Gun98/STM32-FreeRTOS-Sensor-Controller/Core/Src/main.c

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
/* Includes ------------------------------------------------------------------*/
#include "main.h"
#include "cmsis_os.h"

/* USER CODE BEGIN Includes */
#include "app.h"
#include "app_tasks.h"
#include "app_types.h"

#include "FreeRTOS.h"
#include "self_test.h"
#include "stream_buffer.h"
#include "system_health.h"
#include "task.h"
#include "uart_protocol.h"
#include "uart_tx.h"
/* USER CODE END Includes */

I2C_HandleTypeDef hi2c1;

IWDG_HandleTypeDef hiwdg;

TIM_HandleTypeDef htim2;
TIM_HandleTypeDef htim3;
TIM_HandleTypeDef htim4;

UART_HandleTypeDef huart2;
DMA_HandleTypeDef hdma_usart2_tx;

/* Definitions for appTask */
osThreadId_t appTaskHandle;
const osThreadAttr_t appTask_attributes = {
  .name = "appTask",
  .stack_size = 512 * 4,
  .priority = (osPriority_t) osPriorityNormal,
};
/* Definitions for heartbeatTask */
osThreadId_t heartbeatTaskHandle;
const osThreadAttr_t heartbeatTask_attributes = {
  .name = "heartbeatTask",
  .stack_size = 128 * 4,
  .priority = (osPriority_t) osPriorityLow,
};
/* Definitions for consumerTask */
osThreadId_t consumerTaskHandle;
const osThreadAttr_t consumerTask_attributes = {
  .name = "consumerTask",
  .stack_size = 128 * 4,
  .priority = (osPriority_t) osPriorityBelowNormal,
};
/* Definitions for eventTask */
osThreadId_t eventTaskHandle;
const osThreadAttr_t eventTask_attributes = {
  .name = "eventTask",
  .stack_size = 128 * 4,
  .priority = (osPriority_t) osPriorityBelowNormal,
};
/* Definitions for monitorTask */
osThreadId_t monitorTaskHandle;
const osThreadAttr_t monitorTask_attributes = {
  .name = "monitorTask",
  .stack_size = 128 * 4,
  .priority = (osPriority_t) osPriorityLow,
};
/* Definitions for commandTask */
osThreadId_t commandTaskHandle;
const osThreadAttr_t commandTask_attributes = {
  .name = "commandTask",
  .stack_size = 384 * 4,
  .priority = (osPriority_t) osPriorityNormal,
};
/* Definitions for watchdogTask */
osThreadId_t watchdogTaskHandle;
const osThreadAttr_t watchdogTask_attributes = {
  .name = "watchdogTask",
  .stack_size = 128 * 4,
  .priority = (osPriority_t) osPriorityNormal,
};
/* Definitions for uartTxTask */
osThreadId_t uartTxTaskHandle;
const osThreadAttr_t uartTxTask_attributes = {
  .name = "uartTxTask",
  .stack_size = 256 * 4,
  .priority = (osPriority_t) osPriorityNormal,
};
/* Definitions for counterQueue */
osMessageQueueId_t counterQueueHandle;
const osMessageQueueAttr_t counterQueue_attributes = {
  .name = "counterQueue"
};
/* Definitions for controlQueue */
osMessageQueueId_t controlQueueHandle;
const osMessageQueueAttr_t controlQueue_attributes = {
  .name = "controlQueue"
};
/* Definitions for uartTxQueue */
osMessageQueueId_t uartTxQueueHandle;
const osMessageQueueAttr_t uartTxQueue_attributes = {
  .name = "uartTxQueue"
};
/* Definitions for statusTimer */
osTimerId_t statusTimerHandle;
const osTimerAttr_t statusTimer_attributes = {
  .name = "statusTimer"
};
/* Definitions for systemEvent */
osEventFlagsId_t systemEventHandle;
const osEventFlagsAttr_t systemEvent_attributes = {
  .name = "systemEvent"
};
/* Definitions for healthEvent */
osEventFlagsId_t healthEventHandle;
const osEventFlagsAttr_t healthEvent_attributes = {
  .name = "healthEvent"
};
/* USER CODE BEGIN PV */
static StreamBufferHandle_t
    uartRxStreamBufferHandle = NULL;
/* USER CODE END PV */

void SystemClock_Config(void);
static void MX_GPIO_Init(void);
static void MX_DMA_Init(void);
static void MX_TIM3_Init(void);
static void MX_USART2_UART_Init(void);
static void MX_I2C1_Init(void);
static void MX_TIM4_Init(void);
static void MX_TIM2_Init(void);
static void MX_IWDG_Init(void);
void StartAppTask(void *argument);
void StartHeartbeatTask(void *argument);
void StartConsumerTask(void *argument);
void StartEventTask(void *argument);
void StartMonitorTask(void *argument);
void StartCommandTask(void *argument);
void StartWatchdogTask(void *argument);
void StartUartTxTask(void *argument);
void StatusTimerCallback(void *argument);

/**
  * @brief  The application entry point.
  * @retval int
  */
int main(void)
{

  /* USER CODE BEGIN 1 */
  SystemHealth_CaptureResetCause(
      RCC->CSR);
/* USER CODE END 1 */

  /* MCU Configuration--------------------------------------------------------*/

  /* Reset of all peripherals, Initializes the Flash interface and the Systick. */
  HAL_Init();

  /* USER CODE BEGIN Init */
  __HAL_RCC_CLEAR_RESET_FLAGS();

  #if defined(DEBUG)
    __HAL_DBGMCU_FREEZE_IWDG();
  #endif

  __HAL_RCC_CLEAR_RESET_FLAGS();
/* USER CODE END Init */

  /* Configure the system clock */
  SystemClock_Config();

  /* Initialize all configured peripherals */
  MX_GPIO_Init();
  MX_DMA_Init();
  MX_TIM3_Init();
  MX_USART2_UART_Init();
  MX_I2C1_Init();
  MX_TIM4_Init();
  MX_TIM2_Init();
  MX_IWDG_Init();
  /* USER CODE BEGIN 2 */
  static const AppHardware_t hardware =
  {
      .i2c = &hi2c1,
      .uart = &huart2,

      .hcsr04_timer = &htim3,
      .hcsr04_channel = TIM_CHANNEL_1,
      .hcsr04_trig_port = GPIOB,
      .hcsr04_trig_pin = GPIO_PIN_5,

      .buzzer_timer = &htim4,
      .buzzer_channel = TIM_CHANNEL_1,

      .servo_timer = &htim2,
      .servo_channel = TIM_CHANNEL_3
  };

  App_Init(&hardware);

//  App_Init(&app_hardware);
  /* USER CODE END 2 */

  /* Init scheduler */
  osKernelInitialize();

  /* USER CODE BEGIN RTOS_MUTEX */
  /* add mutexes, ... */
  /* USER CODE END RTOS_MUTEX */

  /* USER CODE BEGIN RTOS_SEMAPHORES */
  /* add semaphores, ... */
  /* USER CODE END RTOS_SEMAPHORES */

  /* Create the timer(s) */
  /* creation of statusTimer */
  statusTimerHandle = osTimerNew(StatusTimerCallback, osTimerPeriodic, NULL, &statusTimer_attributes);

  /* USER CODE BEGIN RTOS_TIMERS */
  /* start timers, add new ones, ... */
  /* USER CODE END RTOS_TIMERS */

  /* Create the queue(s) */
  /* creation of counterQueue */
  counterQueueHandle = osMessageQueueNew (4, sizeof(SensorMessage_t), &counterQueue_attributes);

  /* creation of controlQueue */
  controlQueueHandle = osMessageQueueNew (8, sizeof(uint8_t), &controlQueue_attributes);

  /* creation of uartTxQueue */
  uartTxQueueHandle = osMessageQueueNew (4, sizeof(UartTxMessage_t), &uartTxQueue_attributes);

  /* USER CODE BEGIN RTOS_QUEUES */
  /* add queues, ... */
  /*
   * UART RX Byte Stream
   *
   * 전체 저장 공간: 64Byte
   * Trigger Level: 1Byte
   */
  uartRxStreamBufferHandle =
      xStreamBufferCreate(
          64U,
          1U);
  /* USER CODE END RTOS_QUEUES */

  /* Create the thread(s) */
  /* creation of appTask */
  appTaskHandle = osThreadNew(StartAppTask, NULL, &appTask_attributes);

  /* creation of heartbeatTask */
  heartbeatTaskHandle = osThreadNew(StartHeartbeatTask, NULL, &heartbeatTask_attributes);

  /* creation of consumerTask */
  consumerTaskHandle = osThreadNew(StartConsumerTask, NULL, &consumerTask_attributes);

  /* creation of eventTask */
  eventTaskHandle = osThreadNew(StartEventTask, NULL, &eventTask_attributes);

  /* creation of monitorTask */
  monitorTaskHandle = osThreadNew(StartMonitorTask, NULL, &monitorTask_attributes);

  /* creation of commandTask */
  commandTaskHandle = osThreadNew(StartCommandTask, NULL, &commandTask_attributes);

  /* creation of watchdogTask */
  watchdogTaskHandle = osThreadNew(StartWatchdogTask, NULL, &watchdogTask_attributes);

  /* creation of uartTxTask */
  uartTxTaskHandle = osThreadNew(StartUartTxTask, NULL, &uartTxTask_attributes);

  /* USER CODE BEGIN RTOS_THREADS */
  /* add threads, ... */
  /* USER CODE END RTOS_THREADS */

  /* Create the event(s) */
  /* creation of systemEvent */
  systemEventHandle = osEventFlagsNew(&systemEvent_attributes);

  /* creation of healthEvent */
  healthEventHandle = osEventFlagsNew(&healthEvent_attributes);

  /* USER CODE BEGIN RTOS_EVENTS */
  const AppTasksContext_t app_tasks_context =
  {
      .counter_queue = counterQueueHandle,
      .control_queue = controlQueueHandle,
      .system_event = systemEventHandle,
      .status_timer = statusTimerHandle
  };

  const UartProtocolContext_t protocol_context =
  {
      .uart = &huart2,
      .rx_stream_buffer = uartRxStreamBufferHandle,
      .control_queue = controlQueueHandle
  };

  const SystemHealthContext_t health_context =
  {
      .iwdg = &hiwdg,
      .health_event = healthEventHandle,
      .app_task = appTaskHandle,
      .heartbeat_task = heartbeatTaskHandle,
      .consumer_task = consumerTaskHandle,
      .event_task = eventTaskHandle,
      .monitor_task = monitorTaskHandle,
      .command_task = commandTaskHandle,
      .watchdog_task = watchdogTaskHandle,
      .uart_tx_task = uartTxTaskHandle
  };

  const SelfTestRtosObjects_t self_test_objects =
  {
      .app_task = appTaskHandle,
      .heartbeat_task = heartbeatTaskHandle,
      .consumer_task = consumerTaskHandle,
      .event_task = eventTaskHandle,
      .monitor_task = monitorTaskHandle,
      .command_task = commandTaskHandle,
      .watchdog_task = watchdogTaskHandle,
      .uart_tx_task = uartTxTaskHandle,
      .counter_queue = counterQueueHandle,
      .control_queue = controlQueueHandle,
      .uart_tx_queue = uartTxQueueHandle,
      .uart_rx_stream_buffer = uartRxStreamBufferHandle,
      .status_timer = statusTimerHandle,
      .system_event = systemEventHandle,
      .health_event = healthEventHandle
  };

  UartTx_Init(
      &huart2,
      uartTxQueueHandle,
      uartTxTaskHandle);

  AppTasks_Init(
      &app_tasks_context);

  UartProtocol_Init(
      &protocol_context);

  SystemHealth_Init(
      &health_context);

  if (SelfTest_Init(
          &hi2c1,
          &self_test_objects) == 0U)
  {
    Error_Handler();
  }
  /* add events, ... */
/* USER CODE END RTOS_EVENTS */

  /* Start scheduler */
  osKernelStart();

  /* We should never get here as control is now taken by the scheduler */

  /* Infinite loop */
  /* USER CODE BEGIN WHILE */
  while (1)
  {

    /* USER CODE END WHILE */

    /* USER CODE BEGIN 3 */
  }
  /* USER CODE END 3 */
}

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
/* USER CODE BEGIN 4 */
void HAL_GPIO_EXTI_Callback(
    uint16_t GPIO_Pin)
{
  AppTasks_OnButtonInterrupt(
      GPIO_Pin);
}

void HAL_UART_RxCpltCallback(
    UART_HandleTypeDef *huart)
{
  UartProtocol_OnReceiveComplete(
      huart);
}

void HAL_UART_TxCpltCallback(
    UART_HandleTypeDef *huart)
{
  UartTx_OnTransmitComplete(
      huart);
}

void vApplicationStackOverflowHook(
    TaskHandle_t xTask,
    char *pcTaskName)
{
  (void)xTask;
  (void)pcTaskName;

  SystemHealth_OnStackOverflow();
}

void vApplicationMallocFailedHook(void)
{
  SystemHealth_OnMallocFailed();
}

void HardFault_C(
    uint32_t *fault_stack,
    uint32_t exc_return)
{
  SystemHealth_CaptureHardFault(
      fault_stack,
      exc_return);
}
/* USER CODE END 4 */

/* USER CODE BEGIN Header_StartAppTask */
/**
  * @brief  Function implementing the appTask thread.
  * @param  argument: Not used
  * @retval None
  */
/* USER CODE END Header_StartAppTask */
void StartAppTask(void *argument)
{
  /* USER CODE BEGIN 5 */
	/* USER CODE BEGIN StartAppTask */
  AppTask_Run(argument);
/* USER CODE END StartAppTask */
  /* USER CODE END 5 */
}

/* USER CODE BEGIN Header_StartHeartbeatTask */
/**
* @brief Function implementing the heartbeatTask thread.
* @param argument: Not used
* @retval None
*/
/* USER CODE END Header_StartHeartbeatTask */
void StartHeartbeatTask(void *argument)
{
  /* USER CODE BEGIN StartHeartbeatTask */
  HeartbeatTask_Run(argument);
/* USER CODE END StartHeartbeatTask */
}

/* USER CODE BEGIN Header_StartConsumerTask */
/**
* @brief Function implementing the consumerTask thread.
* @param argument: Not used
* @retval None
*/
/* USER CODE END Header_StartConsumerTask */
void StartConsumerTask(void *argument)
{
  /* USER CODE BEGIN StartConsumerTask */
  ConsumerTask_Run(argument);
/* USER CODE END StartConsumerTask */
}

/* USER CODE BEGIN Header_StartEventTask */
/**
* @brief Function implementing the eventTask thread.
* @param argument: Not used
* @retval None
*/
/* USER CODE END Header_StartEventTask */
void StartEventTask(void *argument)
{
  /* USER CODE BEGIN StartEventTask */
  EventTask_Run(argument);
/* USER CODE END StartEventTask */
}

/* USER CODE BEGIN Header_StartMonitorTask */
/**
* @brief Function implementing the monitorTask thread.
* @param argument: Not used
* @retval None
*/
/* USER CODE END Header_StartMonitorTask */
void StartMonitorTask(void *argument)
{
  /* USER CODE BEGIN StartMonitorTask */
  MonitorTask_Run(argument);
/* USER CODE END StartMonitorTask */
}

/* USER CODE BEGIN Header_StartCommandTask */
/**
* @brief Function implementing the commandTask thread.
* @param argument: Not used
* @retval None
*/
/* USER CODE END Header_StartCommandTask */
void StartCommandTask(void *argument)
{
  /* USER CODE BEGIN StartCommandTask */
  CommandTask_Run(argument);
/* USER CODE END StartCommandTask */
}

/* USER CODE BEGIN Header_StartWatchdogTask */
/**
* @brief Function implementing the watchdogTask thread.
* @param argument: Not used
* @retval None
*/
/* USER CODE END Header_StartWatchdogTask */
void StartWatchdogTask(void *argument)
{
  /* USER CODE BEGIN StartWatchdogTask */
  WatchdogTask_Run(argument);
/* USER CODE END StartWatchdogTask */
}

/* USER CODE BEGIN Header_StartUartTxTask */
/**
* @brief Function implementing the uartTxTask thread.
* @param argument: Not used
* @retval None
*/
/* USER CODE END Header_StartUartTxTask */
void StartUartTxTask(void *argument)
{
  /* USER CODE BEGIN StartUartTxTask */
  UartTxTask_Run(argument);
/* USER CODE END StartUartTxTask */
}

/* StatusTimerCallback function */
void StatusTimerCallback(void *argument)
{
  /* USER CODE BEGIN StatusTimerCallback */
  (void)argument;

  AppTasks_OnStatusTimer();
/* USER CODE END StatusTimerCallback */
}

/**
  * @brief  Period elapsed callback in non blocking mode
  * @note   This function is called  when TIM5 interrupt took place, inside
  * HAL_TIM_IRQHandler(). It makes a direct call to HAL_IncTick() to increment
  * a global variable "uwTick" used as application time base.
  * @param  htim : TIM handle
  * @retval None
  */
void HAL_TIM_PeriodElapsedCallback(TIM_HandleTypeDef *htim)
{
  if (htim->Instance == TIM5)
  {
    HAL_IncTick();
  }
}

/**
  * @brief  This function is executed in case of error occurrence.
  * @retval None
  */
void Error_Handler(void)
{
  /* USER CODE BEGIN Error_Handler_Debug */
  /* User can add his own implementation to report the HAL error return state */
  __disable_irq();
  while (1)
  {
  }
  /* USER CODE END Error_Handler_Debug */
}
#ifdef USE_FULL_ASSERT
/**
  * @brief  Reports the name of the source file and the source line number
  *         where the assert_param error has occurred.
  * @param  file: pointer to the source file name
  * @param  line: assert_param error line source number
  * @retval None
  */
void assert_failed(uint8_t *file, uint32_t line)
{
  /* USER CODE BEGIN 6 */
  /* User can add his own implementation to report the file name and line number,
     ex: printf("Wrong parameters value: file %s on line %d\r\n", file, line) */
  /* USER CODE END 6 */
}
#endif /* USE_FULL_ASSERT */
