Gun98/STM32-FreeRTOS-Sensor-Controller/Core/Inc/app.h

/*
 * app.h
 *
 *  Created on: 2026. 7. 20.
 *      Author: ACER
 */

#ifndef INC_APP_H_
#define INC_APP_H_

#include "main.h"
#include "app_types.h"


typedef struct
{
    I2C_HandleTypeDef *i2c;
    UART_HandleTypeDef *uart;

    TIM_HandleTypeDef *hcsr04_timer;
    uint32_t hcsr04_channel;
    GPIO_TypeDef *hcsr04_trig_port;
    uint16_t hcsr04_trig_pin;

    TIM_HandleTypeDef *buzzer_timer;
    uint32_t buzzer_channel;

    TIM_HandleTypeDef *servo_timer;
    uint32_t servo_channel;
} AppHardware_t;

void App_Init(const AppHardware_t *hardware);

void App_Run(void);

uint8_t App_GetSensorSnapshot(SensorMessage_t *message);

#endif /* INC_APP_H_ */
