Gun98/STM32-FreeRTOS-Sensor-Controller/(commit log)

2026-08-03 Initial commit: STM32 FreeRTOS sensor controller v1.0
2026-08-04 docs: Binary Protocol 상세 문서 분리
2026-08-04 docs: 문제 해결 사례 상세 문서 분리
2026-08-04 docs: Protocol과 문제 해결 상세 문서 전체 정리
2026-08-04 docs: 검증 결과 상세 문서 분리
2026-08-04 docs: 테스트 결과 문서 전체 정리
2026-08-04 docs: 상세 문서 렌더링 오류 수정
